fuzioncode/2GIG-Door-Sensor/README.md

# 2GIG-Door-Sensor
Hardware and Software Design to Make Your Own Very Low Cost Compatible 2GIG Door Sensor Depending on Volumes ~$3 to ~$4.

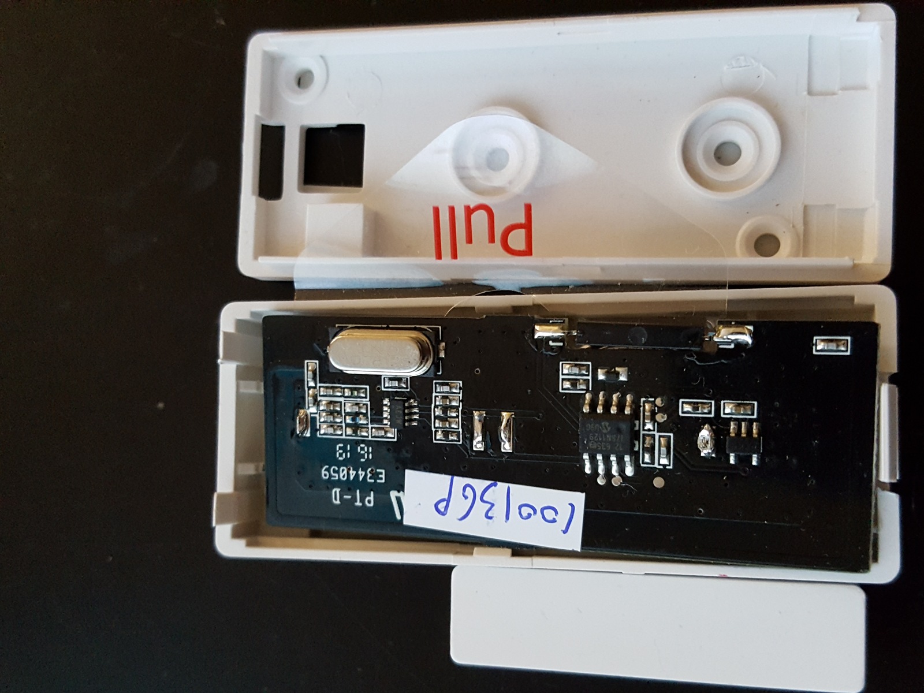
[picture p1: Door Sensor PCB in Enclosure.jpg]
