fuzioncode/2GIG-Door-Sensor/Decoding Door Sensor.jpg

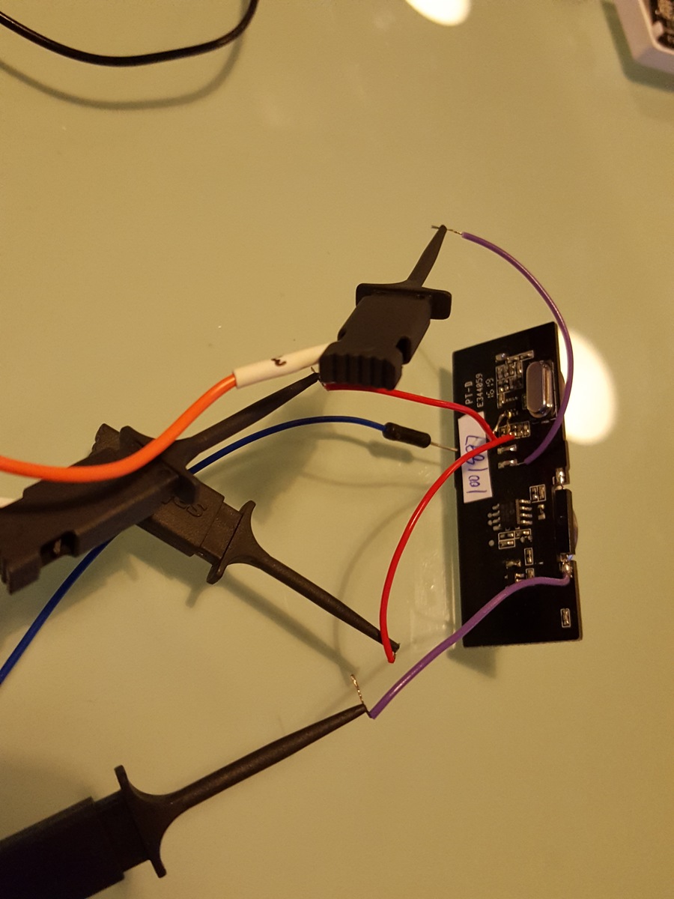
Decoding Door Sensor.jpg
