fuzioncode/2GIG-Door-Sensor/door_sensor_dip_trace_design_files/Rev.A/3D/door_sensor.step

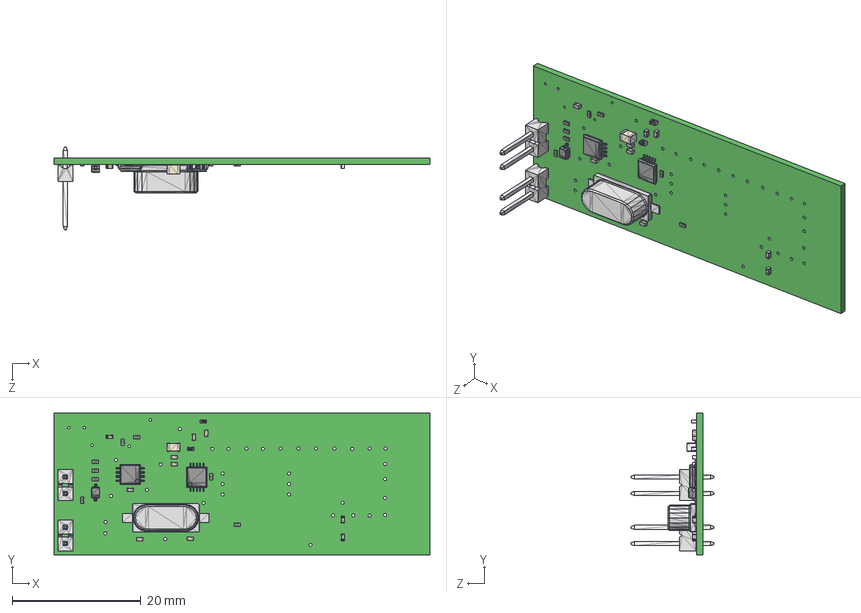
[picture p3: CAD file, 2017-11-03]
door_sensor_dip_trace_design_files/Rev.A/3D/door_sensor.step
58.3 x 22.0 x 12.8 mm
Board
cap_0805
cap_0402 x 10
sod-323
ind_0402 x 2
res_0402 x 8
msop-10
msop-8
hdr-1x2t_2.54_5x2 x 2
hc-49
