fuzioncode/2GIG-Door-Sensor/Security Door Sensor Lid.stl

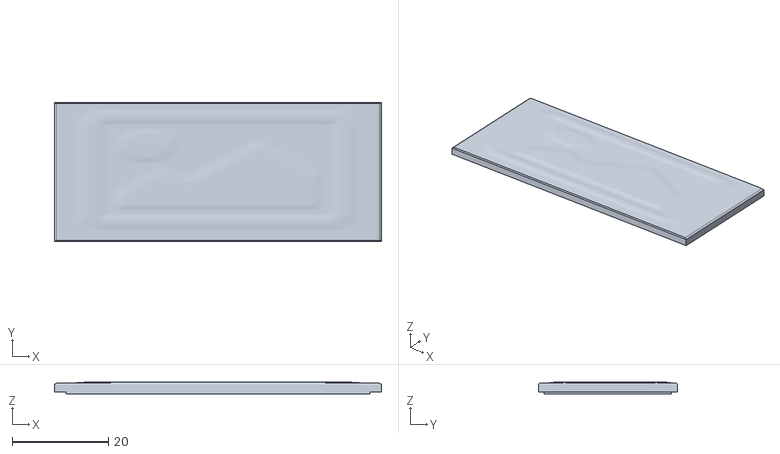
[picture p4: CAD file, 2017-11-03]
Security Door Sensor Lid.stl
68.0 x 28.9 x 2.50
