fuzioncode/2GIG-Door-Sensor/Security Door Sensor Base Enclosure.stl

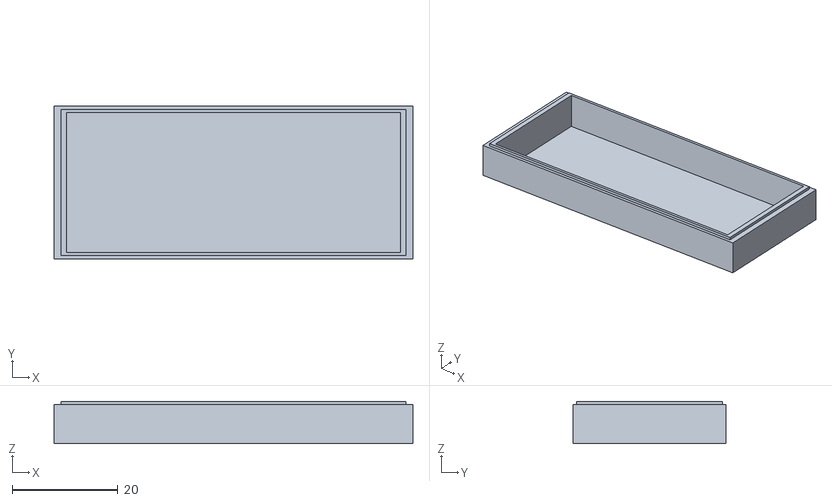
[picture p5: CAD file, 2017-11-03]
Security Door Sensor Base Enclosure.stl
68.0 x 29.0 x 8.00
