fuzioncode/2GIG-Door-Sensor/(list of files, cad)

Other CAD files:
door_sensor_12_26_16/door_sensor/dist/default/production/door_sensor.production.obj
door_sensor_12_26_16/door_sensor/l.obj
door_sensor_firmware_1-3-2017/door_sensor/dist/default/production/door_sensor.production.obj
door_sensor_firmware_1-3-2017/door_sensor/l.obj
