fuzioncode/2GIG-Door-Sensor/door_sensor_dip_trace_design_files/Rev.A/door_sensor-2016-09-08.pdf

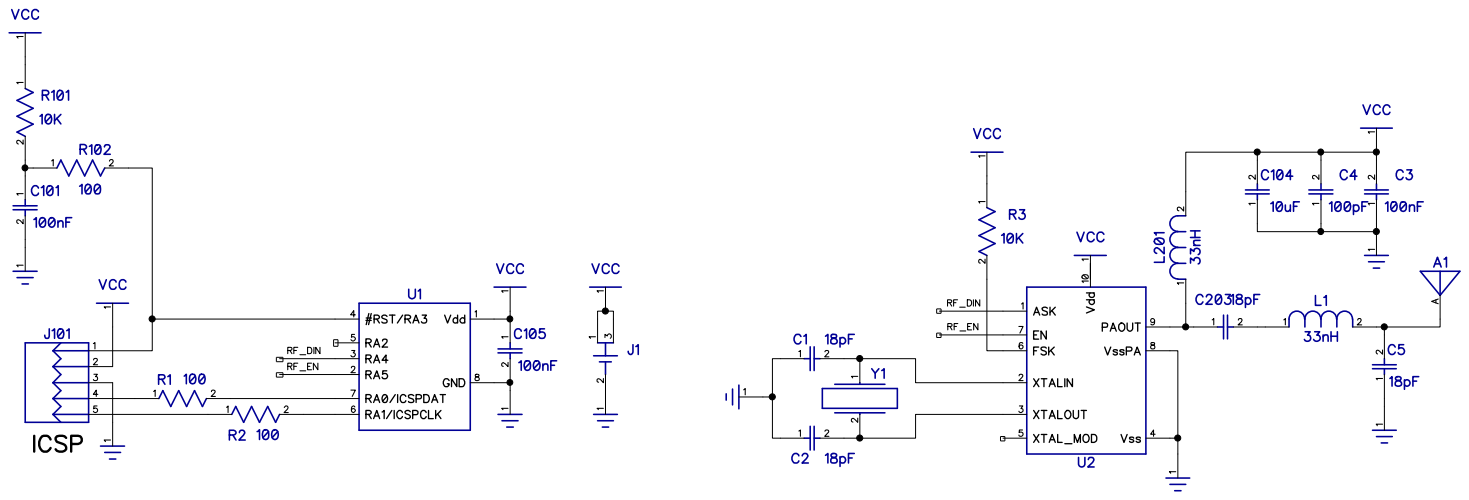
[picture p6: page 1]
