fuzioncode/2GIG-Door-Sensor/door_sensor_dip_trace_design_files/Rev.A/door_sensor-2016-11-09.pdf

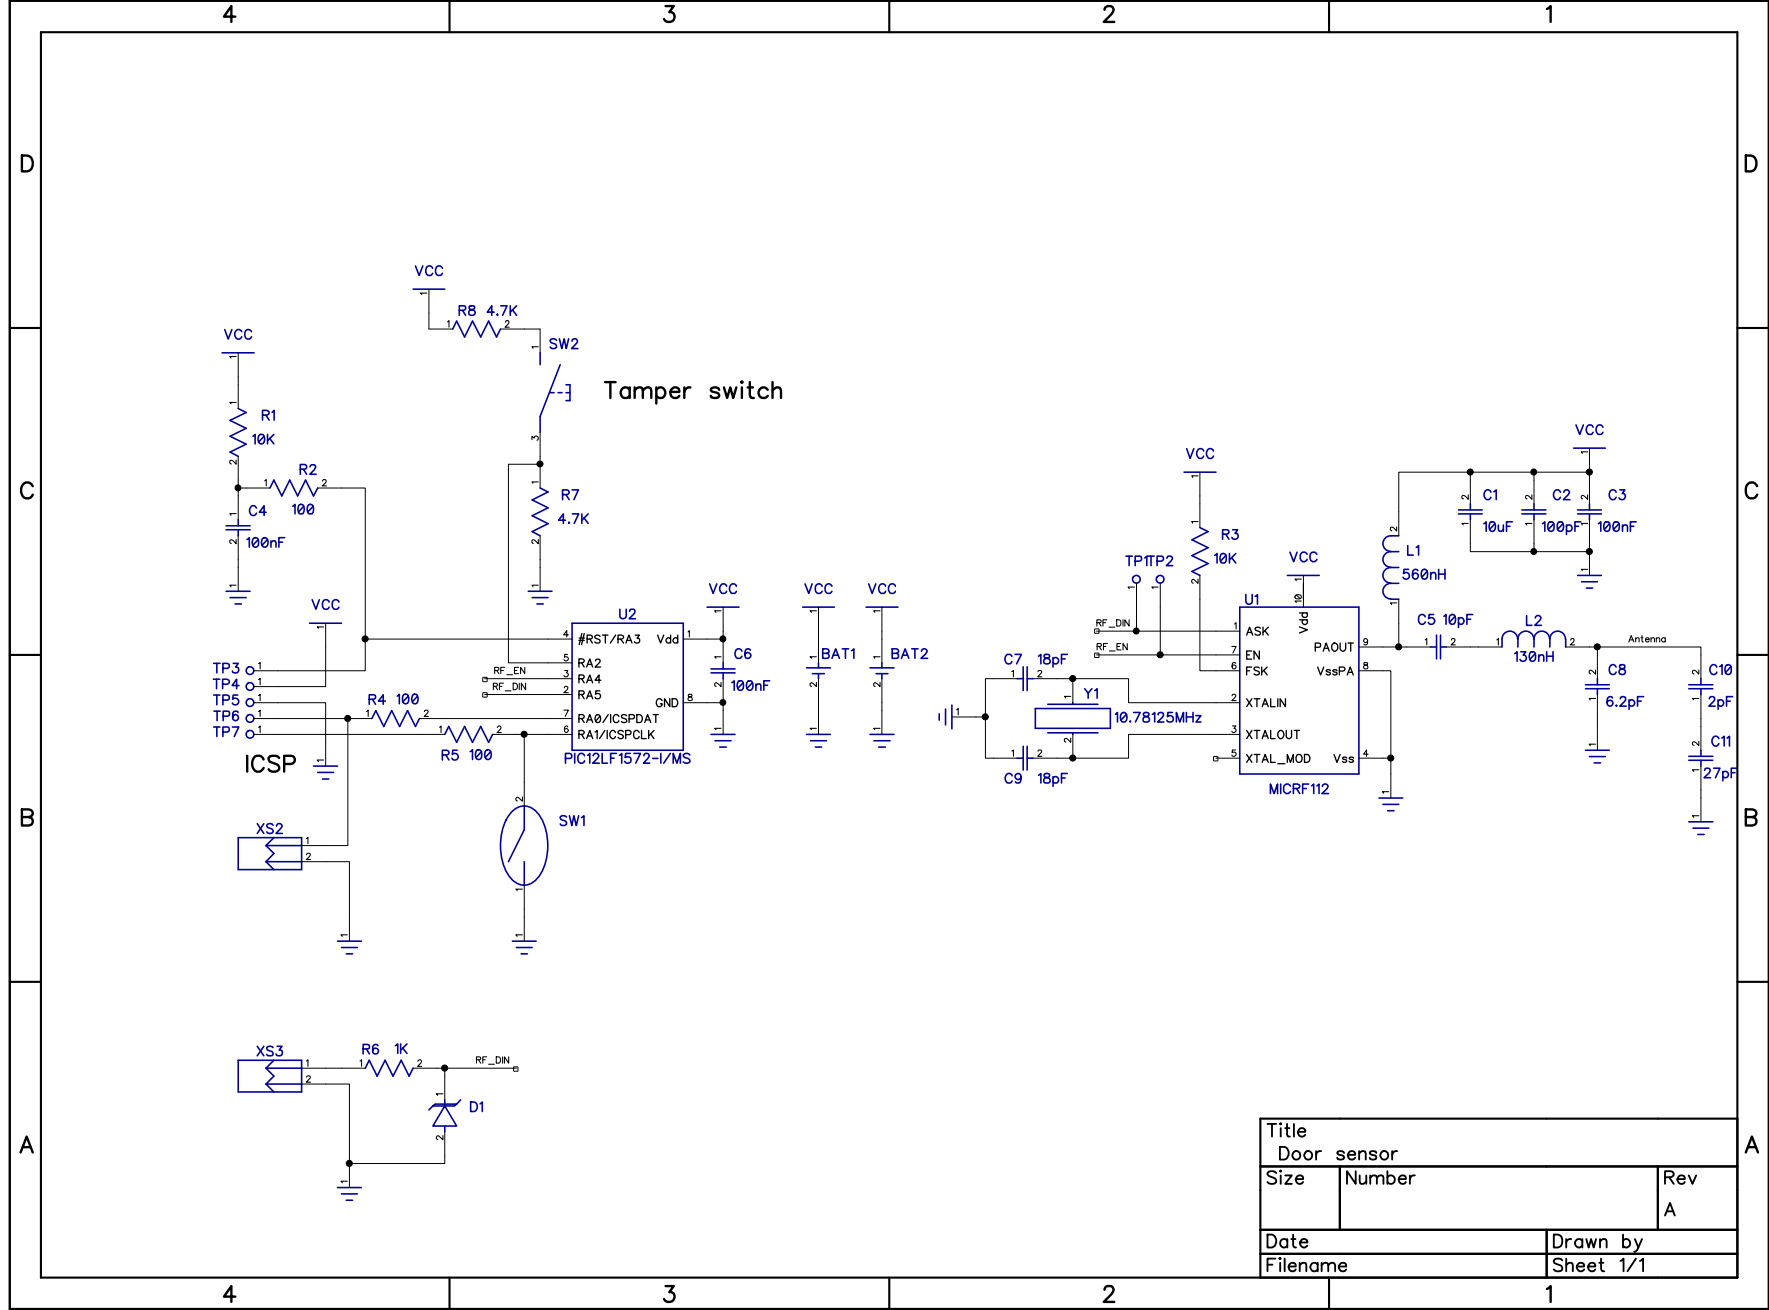
[picture p8: page 1]
