fuzioncode/2GIG-Door-Sensor/door_sensor_dip_trace_design_files/Rev.A/door_sensor-2016-09-16.pdf

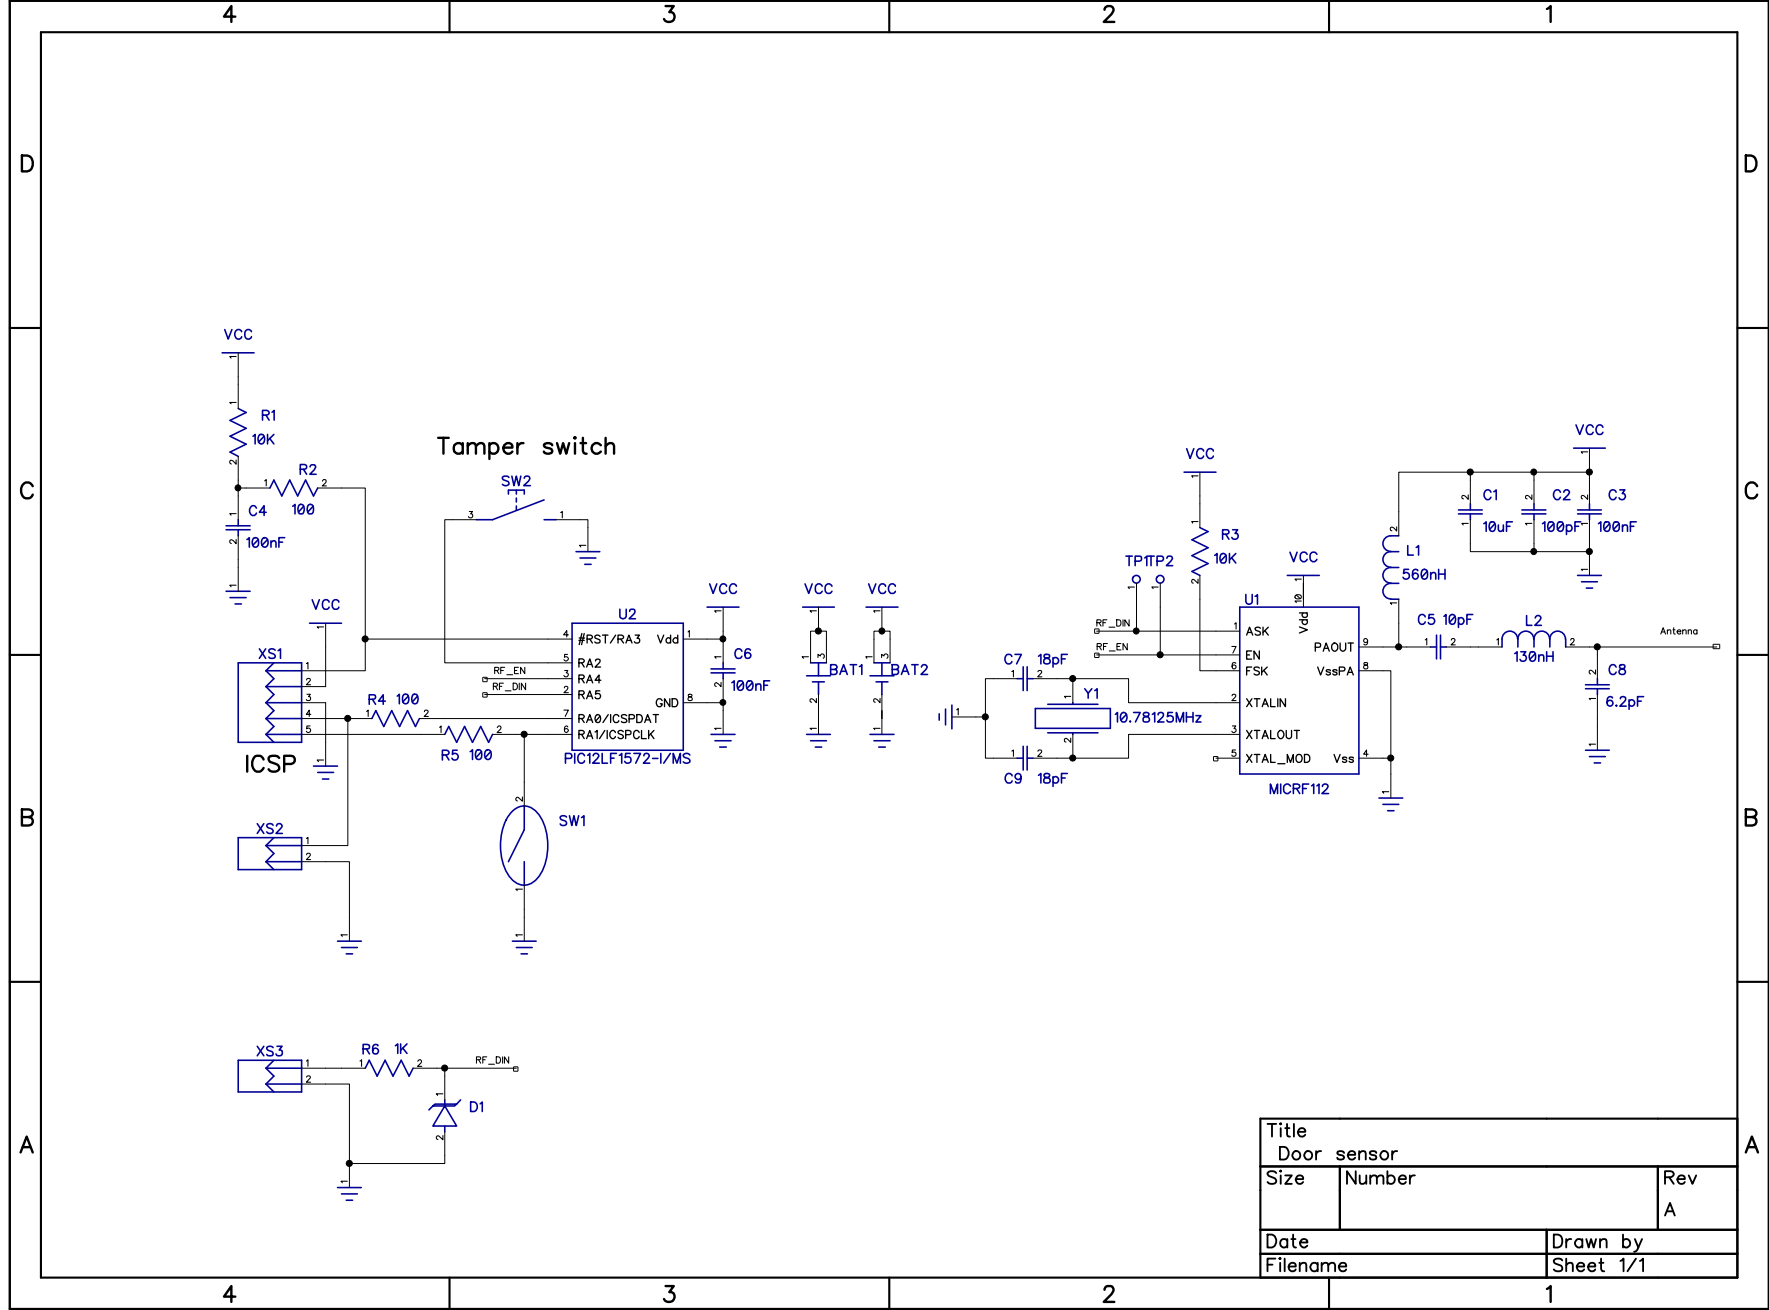
[picture p9: page 1]
