fuzioncode/2GIG-Door-Sensor/(list of files, drawings)

Other design files:
door_sensor_dip_trace_design_files/Rev.A/door_sensor.dch
door_sensor_dip_trace_design_files/Rev.A/door_sensor.dip
