fuzioncode/2GIG-Door-Sensor/(commit log)

2017-11-03 This Version Has All the Required CRC Checking
    [door_sensor.production.obj, l.obj]
2017-11-03 3D View of the PCB
    [door_sensor.step]
2017-11-03 Main Door Sensor Schematic
2017-11-03 All Board and Schematic Design Files
    [BOM.csv, BOM.xls, door_sensor.dch, door_sensor.dip, door_sensor.step]
2017-11-03 Enclosure for Door Sensor Base and Lid
    [Security Door Sensor Base Enclosure.stl, Security Door Sensor Lid.stl]
2017-11-03 Pictures of Completed PCB Board and Enclosure
